Talw3g/ctahr_board/ctahr_board.kicad_pcb

## KiCad design ctahr_board.kicad_pcb (2024-09-01)

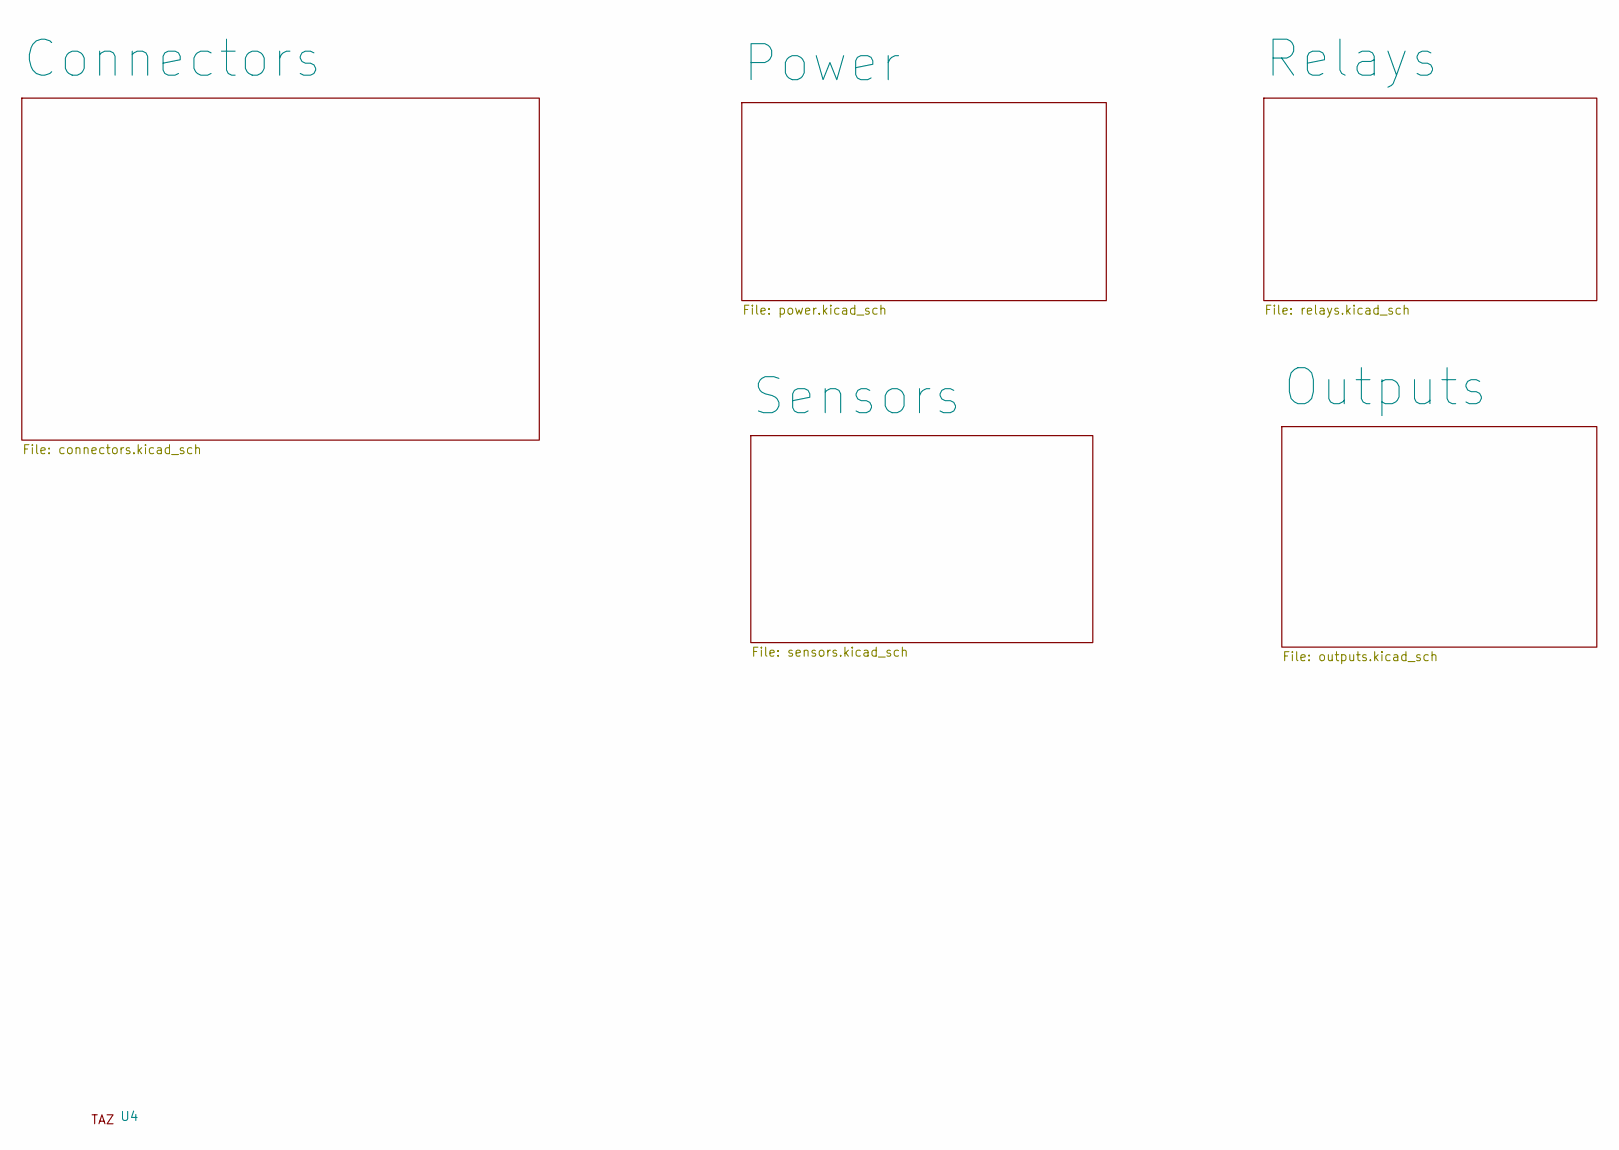
[picture p1: schematic ctahr_board.kicad_sch]

Parts:
U4: taz

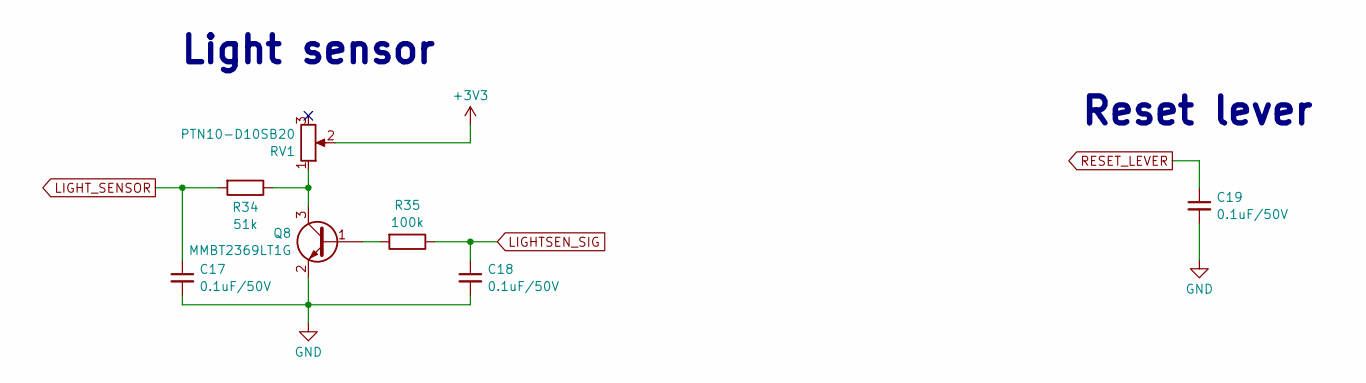
[picture p2: schematic sensors.kicad_sch]

Parts:
C17, C18, C19: 0.1uF/50V; C_0603_1608Metric_Pad1.08x0.95mm_HandSolder
Q8: MMBT2369LT1G; SOT-23_Handsoldering
R34: 51k; R_0603_1608Metric_Pad0.98x0.95mm_HandSolder
R35: 100k; R_0603_1608Metric_Pad0.98x0.95mm_HandSolder
RV1: PTN10-D10SB20; TRIM_PTN10-D10SB20

Connections:
+3V3: RV1.2; also elsewhere on the board
GND: C17.2, C18.2, C19.2, Q8.2 (E); also elsewhere on the board
LIGHTSEN_SIG: C18.1, R35.1; also elsewhere on the board
LIGHT_SENSOR: C17.1, R34.2; also elsewhere on the board
unnamed: Q8.1 (B), R35.2
unnamed: Q8.3 (C), R34.1, RV1.1
RESET_LEVER: C19.1; also elsewhere on the board

Notes on the sheet:
Reset lever
Light sensor

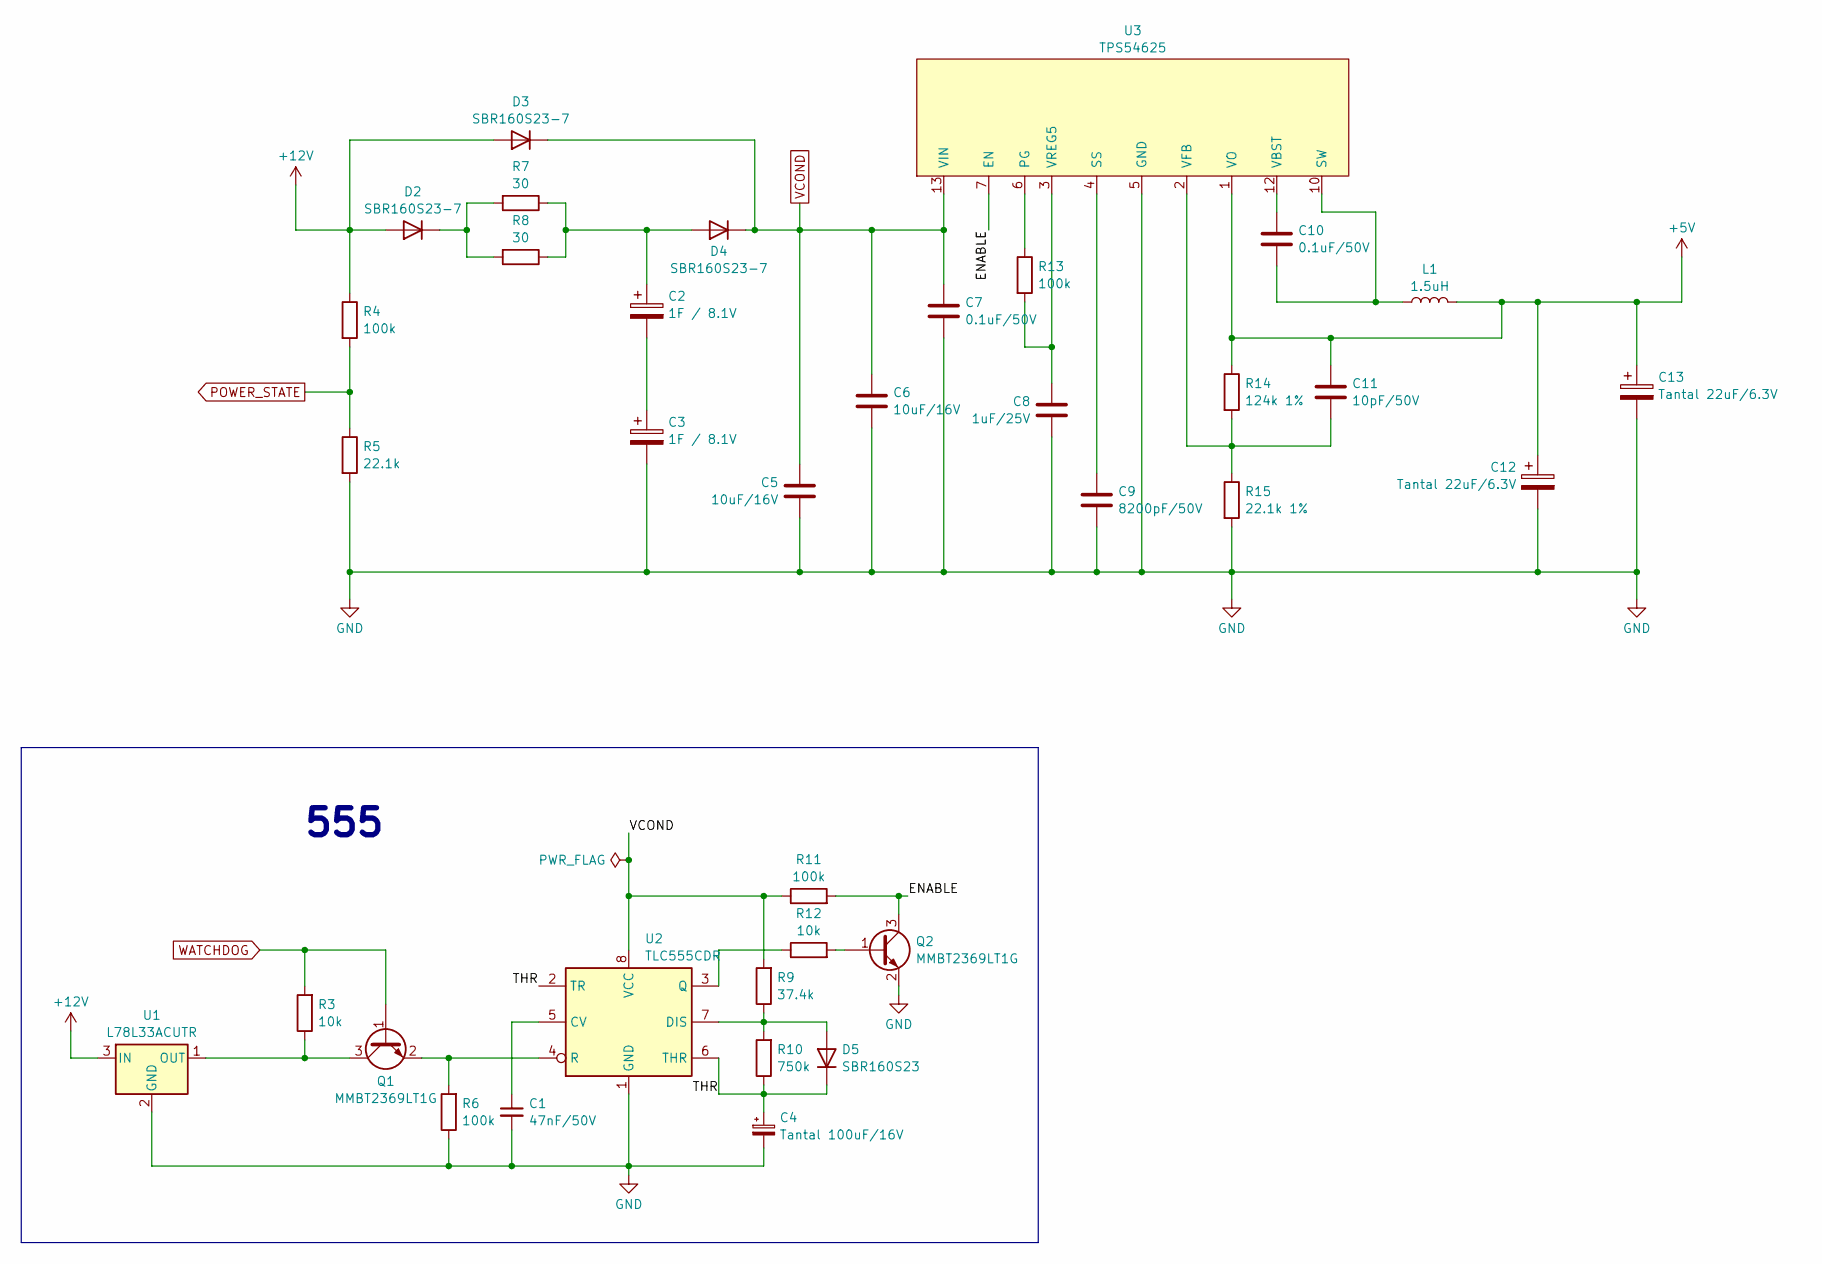
[picture p3: schematic power.kicad_sch]

Parts:
C1: 47nF/50V; C_0603_1608Metric_Pad1.08x0.95mm_HandSolder
C2, C3: 1F / 8.1V; SCMR22G105SRBA0_vertical; Farnell 2856949
C4: Tantal 100uF/16V; CP_EIA-7343-30_AVX-N_Pad2.25x2.55mm_HandSolder
C5, C6: 10uF/16V; C_0805_2012Metric_Pad1.18x1.45mm_HandSolder
C7, C10: 0.1uF/50V; C_0603_1608Metric_Pad1.08x0.95mm_HandSolder
C8: 1uF/25V; C_0603_1608Metric_Pad1.08x0.95mm_HandSolder
C9: 8200pF/50V; C_0603_1608Metric_Pad1.08x0.95mm_HandSolder
C11: 10pF/50V; C_0603_1608Metric_Pad1.08x0.95mm_HandSolder
C12, C13: Tantal 22uF/6.3V; CP_EIA-3216-10_Kemet-I_Pad1.58x1.35mm_HandSolder; Farnell 2321204
D2, D3, D4: SBR160S23-7; SBR160S23; Farnell 1863724
D5: SBR160S23
L1: 1.5uH; L_7.1x6.5_H3; Farnell 2215610
Q1, Q2: MMBT2369LT1G; SOT-23_Handsoldering
R3, R12: 10k; R_0603_1608Metric_Pad0.98x0.95mm_HandSolder
R4, R6, R11, R13: 100k; R_0603_1608Metric_Pad0.98x0.95mm_HandSolder
R5: 22.1k; R_0603_1608Metric_Pad0.98x0.95mm_HandSolder
R7, R8: 30; TE_SM5; Farnell 2331667
R9: 37.4k; R_0603_1608Metric_Pad0.98x0.95mm_HandSolder
R10: 750k; R_0603_1608Metric_Pad0.98x0.95mm_HandSolder
R14: 124k 1%; R_0603_1608Metric_Pad0.98x0.95mm_HandSolder
R15: 22.1k 1%; R_0603_1608Metric_Pad0.98x0.95mm_HandSolder
U1: L78L33ACUTR; SOT-89-3_Handsoldering
U2: TLC555CDR; SOIC-8_3.9x4.9mm_P1.27mm
U3: TPS54625; HTSSOP-14-PWP_Handsolder

Connections:
+5V: C11.1, C12.1, C13.1, L1.2, R14.1, U3.1 (VO); also elsewhere on the board
+12V: D2.2 (A), D3.2 (A), R4.1, U1.3 (IN); also elsewhere on the board
/Power/ENABLE: Q2.3 (C), R11.2, U3.7 (EN)
/Power/THR: C4.1, D5.1 (K), R10.1, U2.2 (TR), U2.6 (THR)
GND: C1.2, C3.2, C4.2, C5.2, C6.2, C7.2, C8.2, C9.2, C12.2, C13.2, Q2.2 (E), R5.2, R6.1, R15.2, U1.2 (GND), U2.1 (GND), U3.5 (GND), U3.8 (GND), U3.9 (GND), U3.15 (GND); also elsewhere on the board
unnamed: C2.2, C3.1
unnamed: C10.2, L1.1, U3.10 (SW), U3.11 (SW)
unnamed: D2.1 (K), R7.2, R8.2
unnamed: C2.1, D4.2 (A), R7.1, R8.1
unnamed: D5.2 (A), R9.1, R10.2, U2.7 (DIS)
unnamed: Q1.3 (C), R3.1, U1.1 (OUT)
unnamed: Q1.2 (E), R6.2, U2.4 (R)
unnamed: Q2.1 (B), R12.2
unnamed: C1.1, U2.5 (CV)
unnamed: R12.1, U2.3 (Q)
unnamed: R13.1, U3.6 (PG)
unnamed: C9.1, U3.4 (SS)
unnamed: C10.1, U3.12 (VBST)
unnamed: C11.2, R14.2, R15.1, U3.2 (VFB)
unnamed: C8.1, R13.2, U3.3 (VREG5)
POWER_STATE: R4.2, R5.1; also elsewhere on the board
VCOND: C5.1, C6.1, C7.1, D3.1 (K), D4.1 (K), R9.2, R11.1, U2.8 (VCC), U3.13 (VIN), U3.14 (VIN)
WATCHDOG: Q1.1 (B), R3.2; also elsewhere on the board

Notes on the sheet:
555

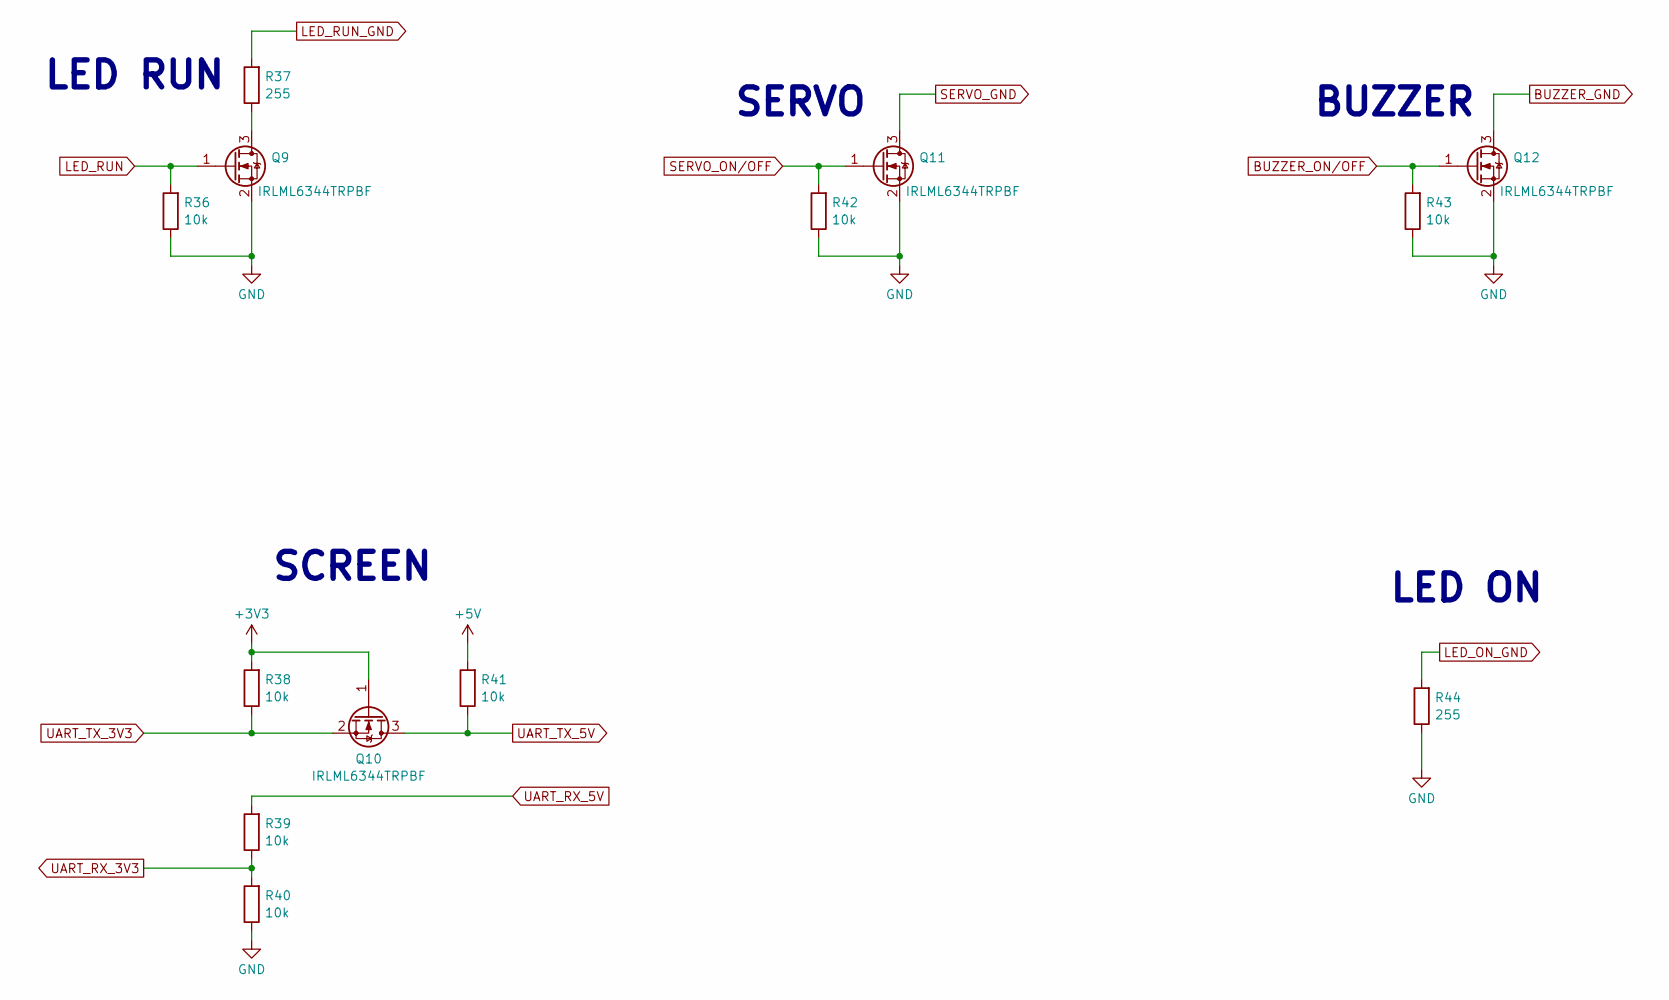
[picture p4: schematic outputs.kicad_sch]

Parts:
Q9, Q10, Q11, Q12: IRLML6344TRPBF; SOT-23_Handsoldering
R36, R38, R39, R40, R41, R42, R43: 10k; R_0603_1608Metric_Pad0.98x0.95mm_HandSolder
R37, R44: 255; R_0603_1608Metric_Pad0.98x0.95mm_HandSolder

Connections:
+3V3: Q10.1 (G), R38.2; also elsewhere on the board
+5V: R41.2; also elsewhere on the board
BUZZER_GND: Q12.3 (D); also elsewhere on the board
BUZZER_ON/OFF: Q12.1 (G), R43.2; also elsewhere on the board
GND: Q9.2 (S), Q11.2 (S), Q12.2 (S), R36.1, R40.1, R42.1, R43.1, R44.1; also elsewhere on the board
LED_ON_GND: R44.2; also elsewhere on the board
LED_RUN: Q9.1 (G), R36.2; also elsewhere on the board
LED_RUN_GND: R37.2; also elsewhere on the board
unnamed: Q9.3 (D), R37.1
SERVO_GND: Q11.3 (D); also elsewhere on the board
SERVO_ON/OFF: Q11.1 (G), R42.2; also elsewhere on the board
UART_RX_3V3: R39.1, R40.2; also elsewhere on the board
UART_RX_5V: R39.2; also elsewhere on the board
UART_TX_3V3: Q10.2 (S), R38.1; also elsewhere on the board
UART_TX_5V: Q10.3 (D), R41.1; also elsewhere on the board

Notes on the sheet:
LED ON
LED RUN
SCREEN
SERVO
BUZZER

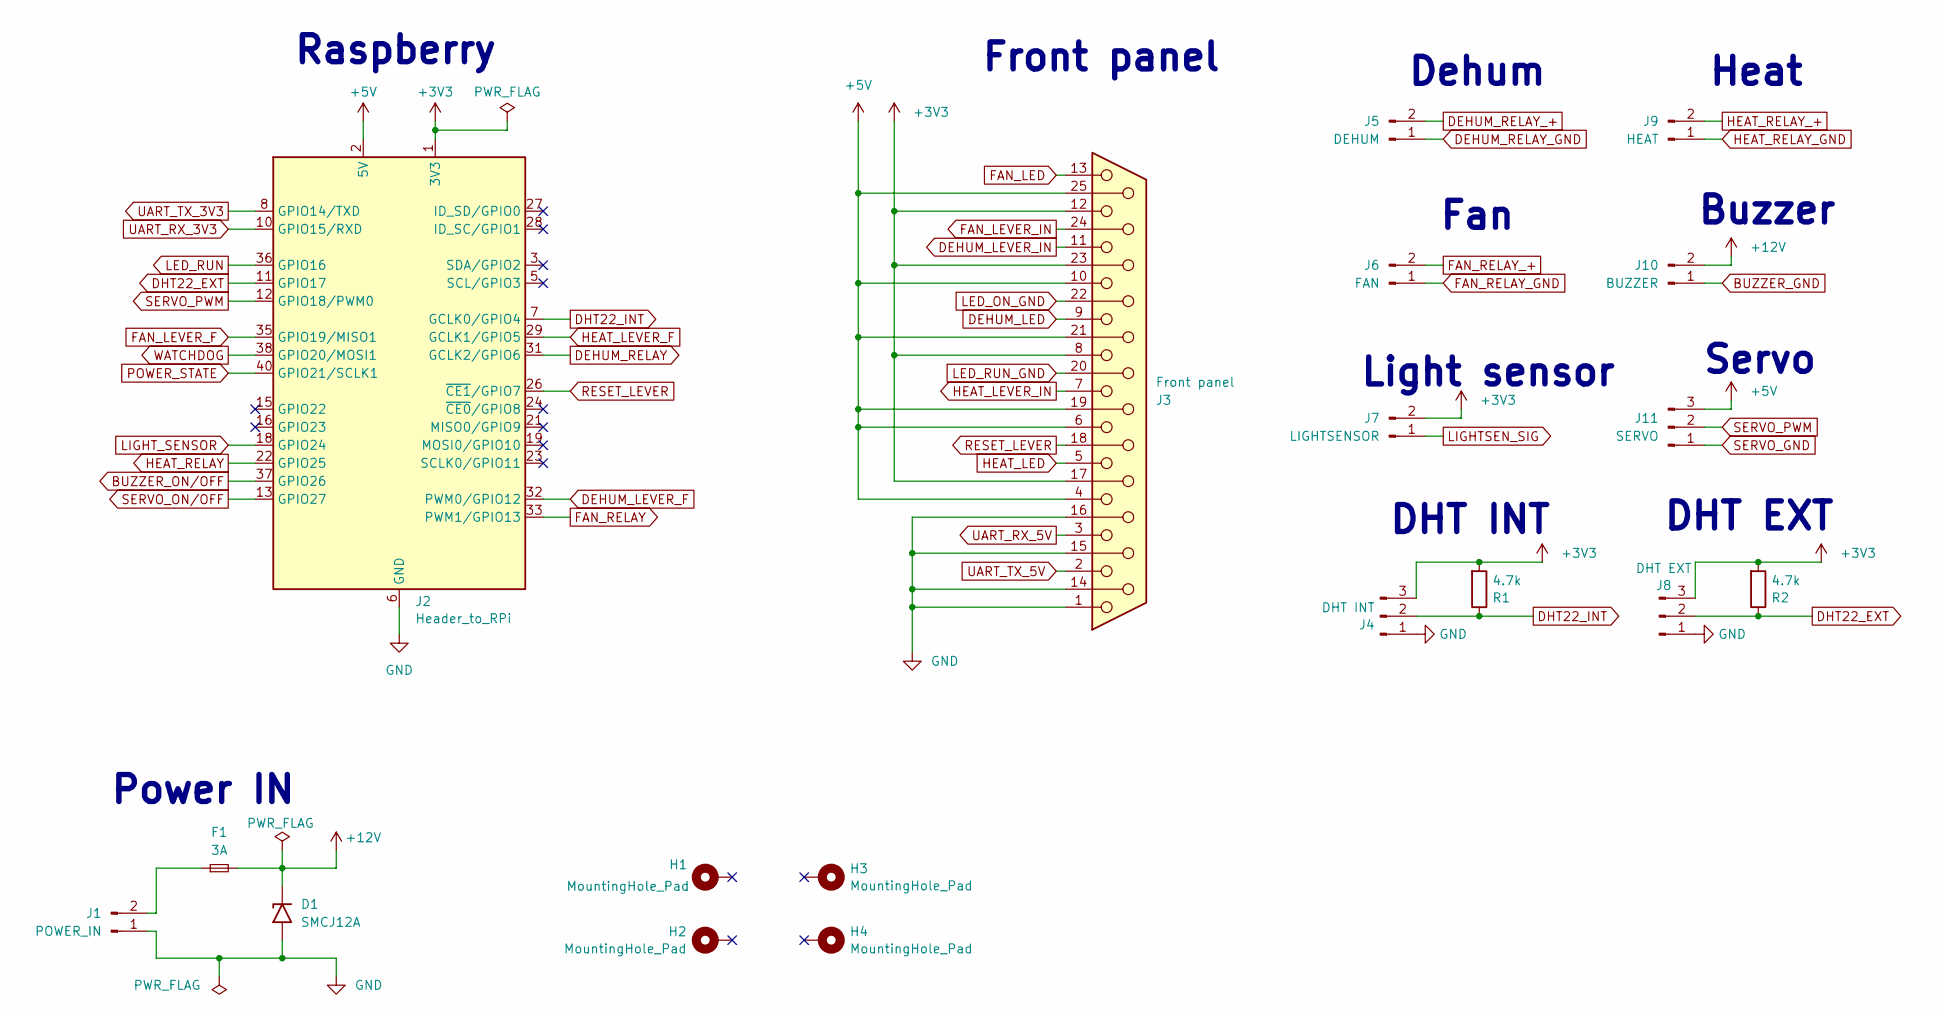
[picture p5: schematic connectors.kicad_sch]

Parts:
D1: SMCJ12A; D_SMC_Handsoldering
F1: 3A; Fuseholder_Littelfuse_Nano2_154x
H1, H2, H3, H4: MountingHole_Pad; MountingHole_2.2mm_M2_ISO14580_Pad_TopBottom
J1: POWER_IN; JST_XH_B2B-XH-A_1x02_P2.50mm_Vertical
J2: Header_to_RPi; PinHeader_2x20_P2.54mm_Vertical
J3: Front panel; DSUB-25_Female_Vertical_P2.77x2.84mm
J4: DHT INT; JST_XH_B3B-XH-A_1x03_P2.50mm_Vertical
J5: DEHUM; JST_XH_B2B-XH-A_1x02_P2.50mm_Vertical
J6: FAN; JST_XH_B2B-XH-A_1x02_P2.50mm_Vertical
J7: LIGHTSENSOR; JST_XH_B2B-XH-A_1x02_P2.50mm_Vertical
J8: DHT EXT; JST_XH_B3B-XH-A_1x03_P2.50mm_Vertical
J9: HEAT; JST_XH_B2B-XH-A_1x02_P2.50mm_Vertical
J10: BUZZER; JST_XH_B2B-XH-A_1x02_P2.50mm_Vertical
J11: SERVO; JST_XH_B3B-XH-A_1x03_P2.50mm_Vertical
R1, R2: 4.7k; R_0603_1608Metric_Pad0.98x0.95mm_HandSolder

Connections:
+3V3: J2.1 (3V3), J2.17 (3V3), J3.8, J3.12, J3.17, J3.23, J4.3, J7.2, J8.3, R1.2, R2.2; also elsewhere on the board
+5V: J2.2 (5V), J2.4 (5V), J3.4, J3.6, J3.10, J3.19, J3.21, J3.25, J11.3; also elsewhere on the board
+12V: D1.1 (A1), F1.2, J10.2; also elsewhere on the board
BUZZER_GND: J10.1; also elsewhere on the board
BUZZER_ON/OFF: J2.37 (GPIO26); also elsewhere on the board
DEHUM_LED: J3.9; also elsewhere on the board
DEHUM_LEVER_F: J2.32 (PWM0/GPIO12); also elsewhere on the board
DEHUM_LEVER_IN: J3.11; also elsewhere on the board
DEHUM_RELAY: J2.31 (GCLK2/GPIO6); also elsewhere on the board
DEHUM_RELAY_+: J5.2; also elsewhere on the board
DEHUM_RELAY_GND: J5.1; also elsewhere on the board
DHT22_EXT: J2.11 (GPIO17), J8.2, R2.1
DHT22_INT: J2.7 (GCLK0/GPIO4), J4.2, R1.1
FAN_LED: J3.13; also elsewhere on the board
FAN_LEVER_F: J2.35 (GPIO19/MISO1); also elsewhere on the board
FAN_LEVER_IN: J3.24; also elsewhere on the board
FAN_RELAY: J2.33 (PWM1/GPIO13); also elsewhere on the board
FAN_RELAY_+: J6.2; also elsewhere on the board
FAN_RELAY_GND: J6.1; also elsewhere on the board
GND: D1.2 (A2), J1.1, J2.6 (GND), J2.9 (GND), J2.14 (GND), J2.20 (GND), J2.25 (GND), J2.30 (GND), J2.34 (GND), J2.39 (GND), J3.1, J3.14, J3.15, J3.16, J4.1, J8.1; also elsewhere on the board
HEAT_LED: J3.5; also elsewhere on the board
HEAT_LEVER_F: J2.29 (GCLK1/GPIO5); also elsewhere on the board
HEAT_LEVER_IN: J3.7; also elsewhere on the board
HEAT_RELAY: J2.22 (GPIO25); also elsewhere on the board
HEAT_RELAY_+: J9.2; also elsewhere on the board
HEAT_RELAY_GND: J9.1; also elsewhere on the board
LED_ON_GND: J3.22; also elsewhere on the board
LED_RUN: J2.36 (GPIO16); also elsewhere on the board
LED_RUN_GND: J3.20; also elsewhere on the board
LIGHTSEN_SIG: J7.1; also elsewhere on the board
LIGHT_SENSOR: J2.18 (GPIO24); also elsewhere on the board
unnamed: F1.1, J1.2
POWER_STATE: J2.40 (GPIO21/SCLK1); also elsewhere on the board
RESET_LEVER: J2.26 (~CE1/GPIO7), J3.18; also elsewhere on the board
SERVO_GND: J11.1; also elsewhere on the board
SERVO_ON/OFF: J2.13 (GPIO27); also elsewhere on the board
SERVO_PWM: J2.12 (GPIO18/PWM0), J11.2
UART_RX_3V3: J2.10 (GPIO15/RXD); also elsewhere on the board
UART_RX_5V: J3.3; also elsewhere on the board
UART_TX_3V3: J2.8 (GPIO14/TXD); also elsewhere on the board
UART_TX_5V: J3.2; also elsewhere on the board
WATCHDOG: J2.38 (GPIO20/MOSI1); also elsewhere on the board

Notes on the sheet:
Buzzer
DHT INT
Front panel
Power IN
Heat
DHT EXT
Dehum
Fan
Servo
Light sensor
Raspberry

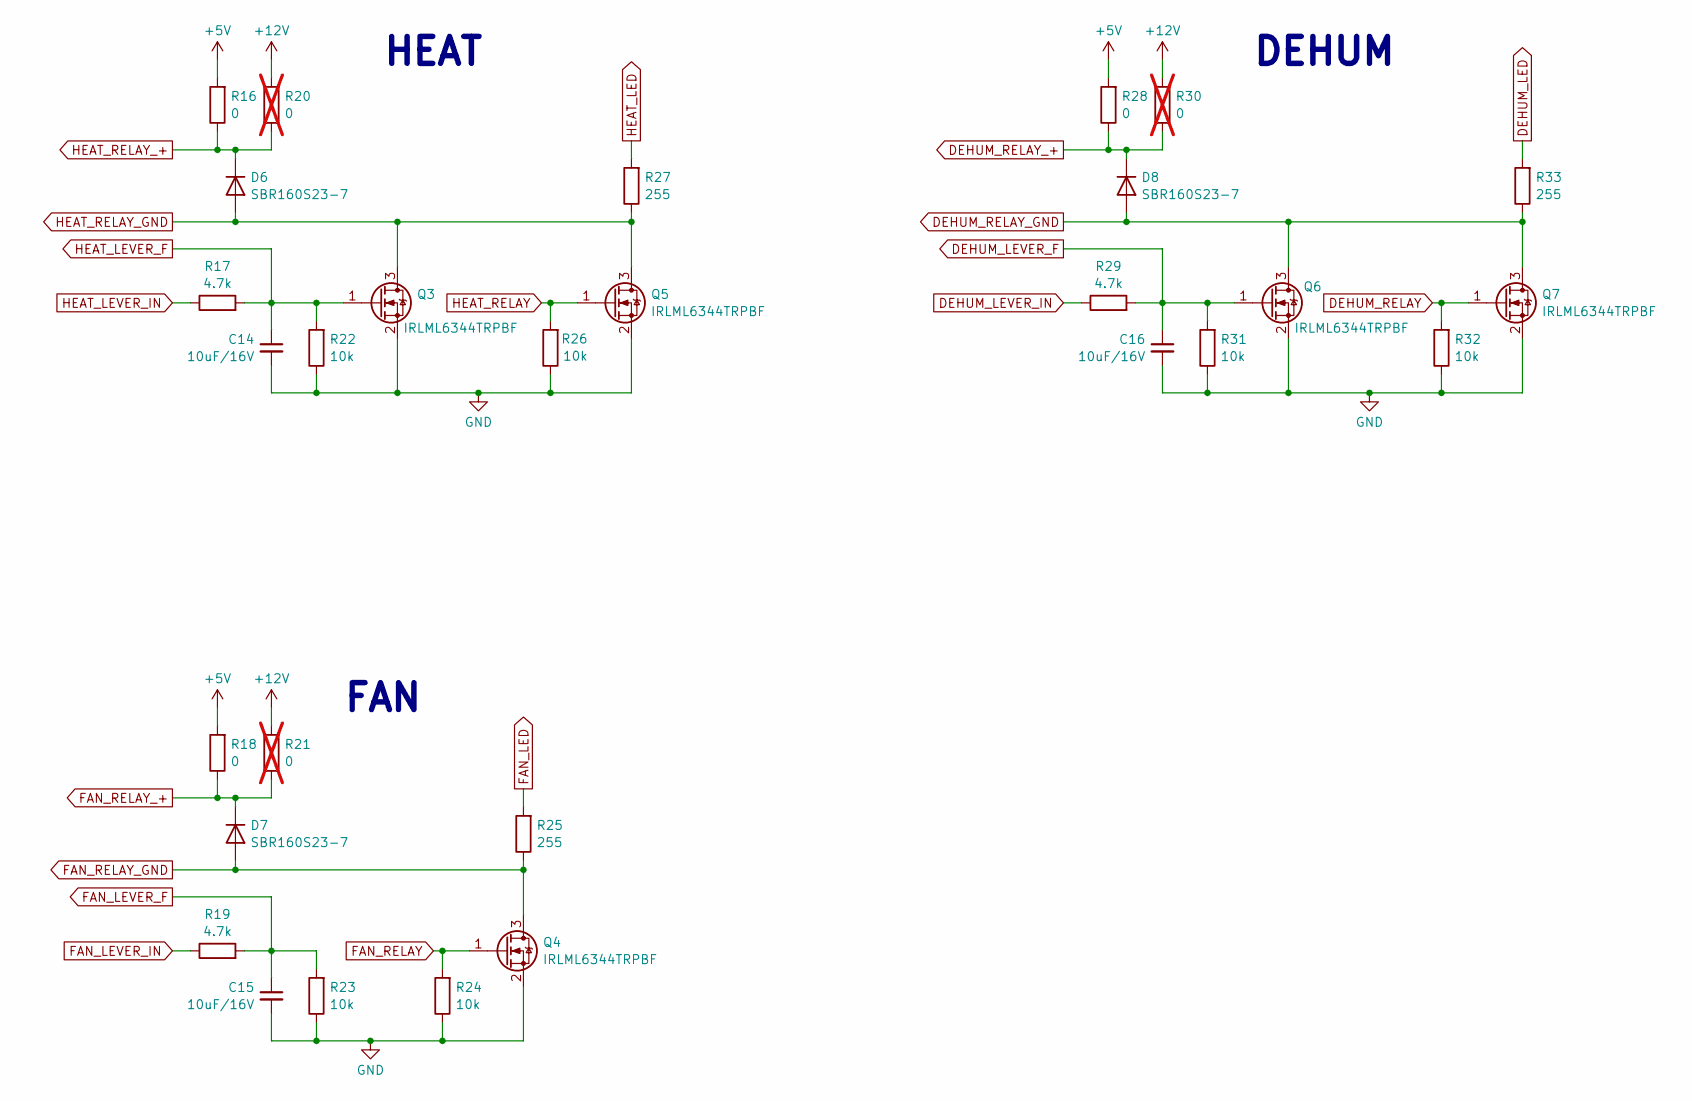
[picture p6: schematic relays.kicad_sch]

Parts:
C14, C15, C16: 10uF/16V; C_0805_2012Metric_Pad1.18x1.45mm_HandSolder
D6, D7, D8: SBR160S23-7; SBR160S23; Farnell 1863724
Q3, Q4, Q5, Q6, Q7: IRLML6344TRPBF; SOT-23_Handsoldering
R16, R18, R28: 0; R_0603_1608Metric_Pad0.98x0.95mm_HandSolder
R17, R19, R29: 4.7k; R_0603_1608Metric_Pad0.98x0.95mm_HandSolder
R20, R21, R30: 0; R_0603_1608Metric_Pad0.98x0.95mm_HandSolder; not fitted
R22, R23, R24, R26, R31, R32: 10k; R_0603_1608Metric_Pad0.98x0.95mm_HandSolder
R25, R27, R33: 255; R_0603_1608Metric_Pad0.98x0.95mm_HandSolder

Connections:
+5V: R16.2, R18.2, R28.2; also elsewhere on the board
+12V: R20.2, R21.2, R30.2; also elsewhere on the board
DEHUM_LED: R33.2; also elsewhere on the board
DEHUM_LEVER_F: C16.1, Q6.1 (G), R29.2, R31.2; also elsewhere on the board
DEHUM_LEVER_IN: R29.1; also elsewhere on the board
DEHUM_RELAY: Q7.1 (G), R32.2; also elsewhere on the board
DEHUM_RELAY_+: D8.1 (K), R28.1, R30.1; also elsewhere on the board
DEHUM_RELAY_GND: D8.2 (A), Q6.3 (D), Q7.3 (D), R33.1; also elsewhere on the board
FAN_LED: R25.2; also elsewhere on the board
FAN_LEVER_F: C15.1, R19.2, R23.2; also elsewhere on the board
FAN_LEVER_IN: R19.1; also elsewhere on the board
FAN_RELAY: Q4.1 (G), R24.2; also elsewhere on the board
FAN_RELAY_+: D7.1 (K), R18.1, R21.1; also elsewhere on the board
FAN_RELAY_GND: D7.2 (A), Q4.3 (D), R25.1; also elsewhere on the board
GND: C14.2, C15.2, C16.2, Q3.2 (S), Q4.2 (S), Q5.2 (S), Q6.2 (S), Q7.2 (S), R22.1, R23.1, R24.1, R26.1, R31.1, R32.1; also elsewhere on the board
HEAT_LED: R27.2; also elsewhere on the board
HEAT_LEVER_F: C14.1, Q3.1 (G), R17.2, R22.2; also elsewhere on the board
HEAT_LEVER_IN: R17.1; also elsewhere on the board
HEAT_RELAY: Q5.1 (G), R26.2; also elsewhere on the board
HEAT_RELAY_+: D6.1 (K), R16.1, R20.1; also elsewhere on the board
HEAT_RELAY_GND: D6.2 (A), Q3.3 (D), Q5.3 (D), R27.1; also elsewhere on the board

Notes on the sheet:
FAN
HEAT
DEHUM

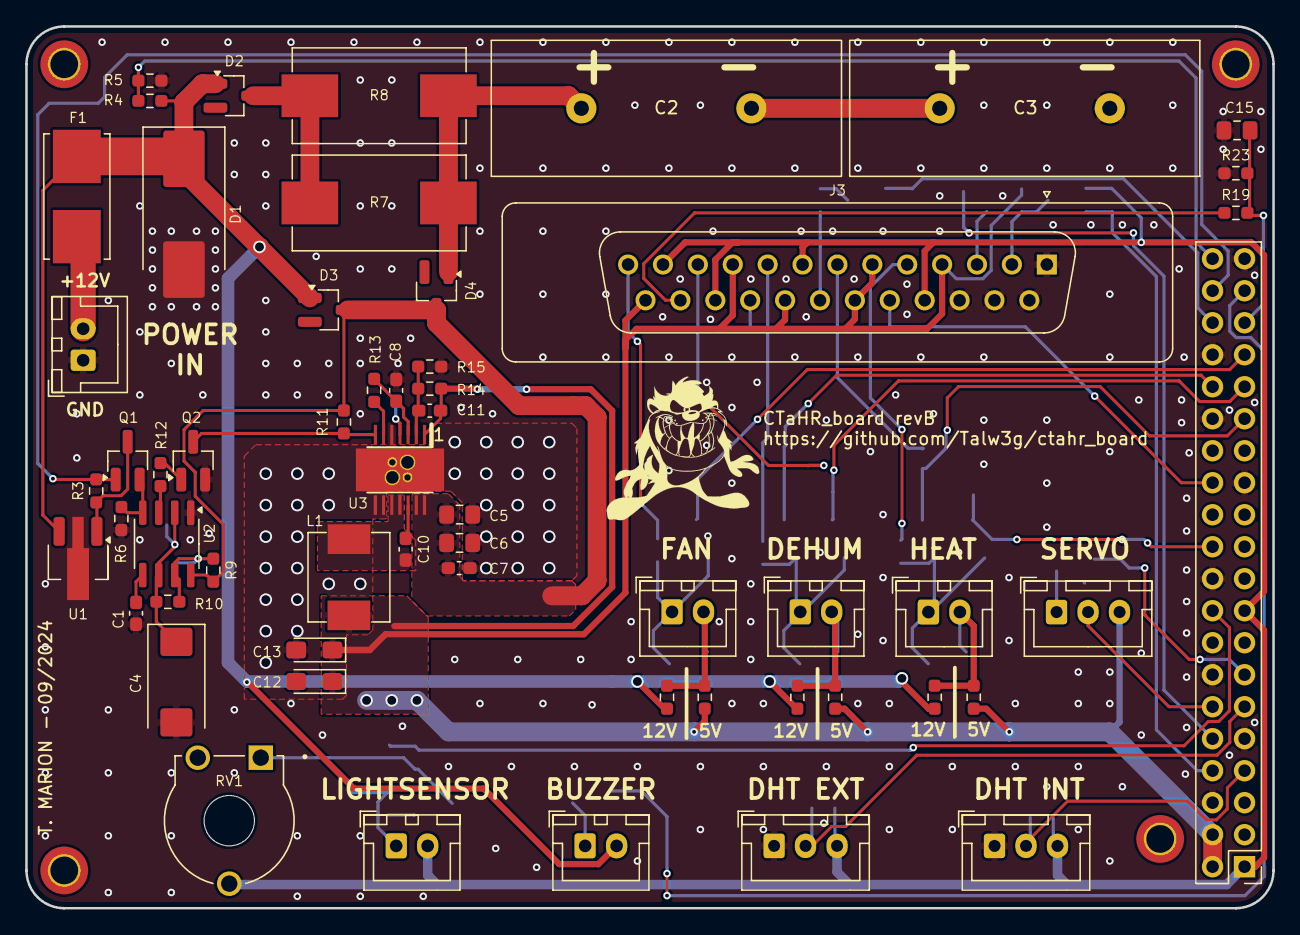
[picture p7: board ctahr_board.kicad_pcb from above]

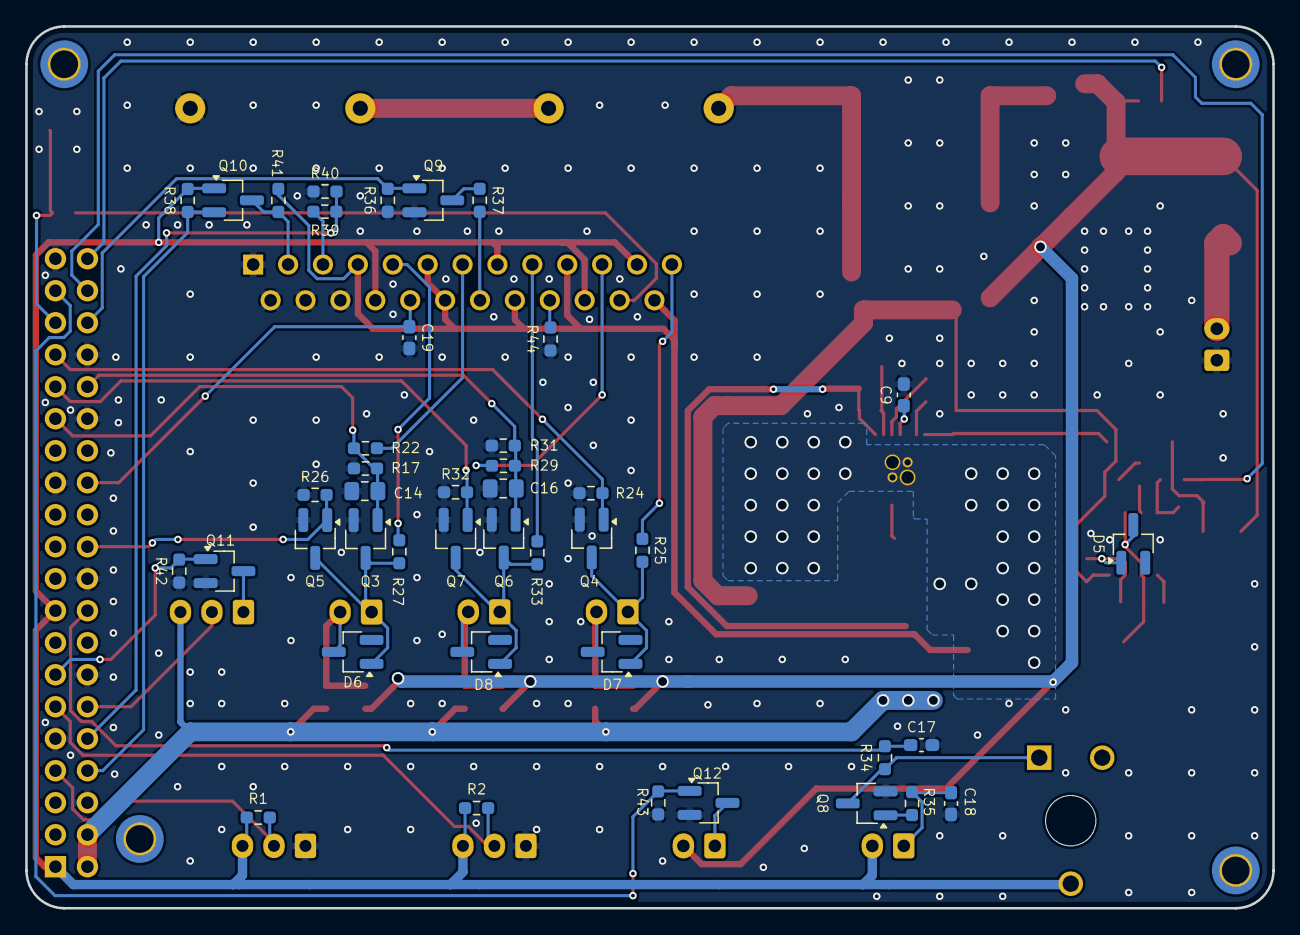
[picture p8: board ctahr_board.kicad_pcb from below]

Board: 2 copper layers, 99.0 x 70.0 mm, 105 parts (43 on the bottom side), 63 nets.
