Talw3g/ctahr_board/(commit log)

2024-08-27 Connectors for RPi and front panel done (sch)
    [connectors.kicad_sch]
2024-08-27 Connectors done, WIP on power
    [connectors.kicad_sch, power.kicad_sch]
2024-08-28 Added power surge protection
    [connectors.kicad_sch, ctahr_board.kicad_sch]
2024-08-29 Schematic done (for now), WIP on layout
    [connectors.kicad_sch, ctahr_board.kicad_pcb, outputs.kicad_sch, power.kicad_sch, relays.kicad_sch, sensors.kicad_sch]
2024-08-30 WIP on layout
    [ctahr_board.kicad_pcb]
2024-08-31 Routing done, need to work on silkscreen
    [connectors.kicad_sch, ctahr_board.kicad_pcb, sensors.kicad_sch]
2024-09-01 All done, pending review
    [ctahr_board.kicad_pcb, ctahr_board.kicad_sch, power.kicad_sch]
